lorenzalber/SnowLens/hardware/SnowLens_Schematic_and_Board.pdf

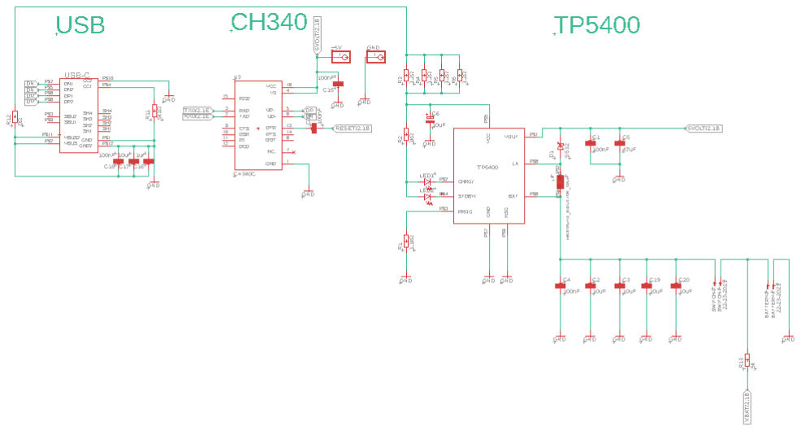
[picture p79: figure]

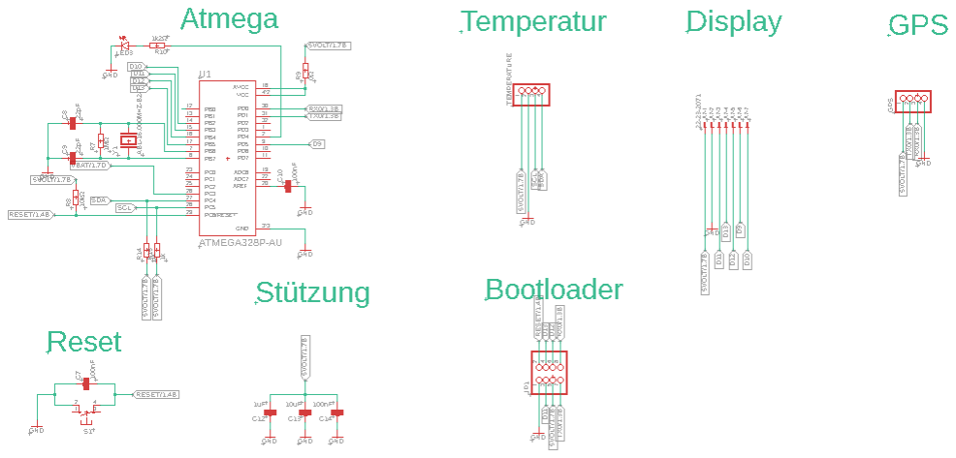
[picture p80: figure]

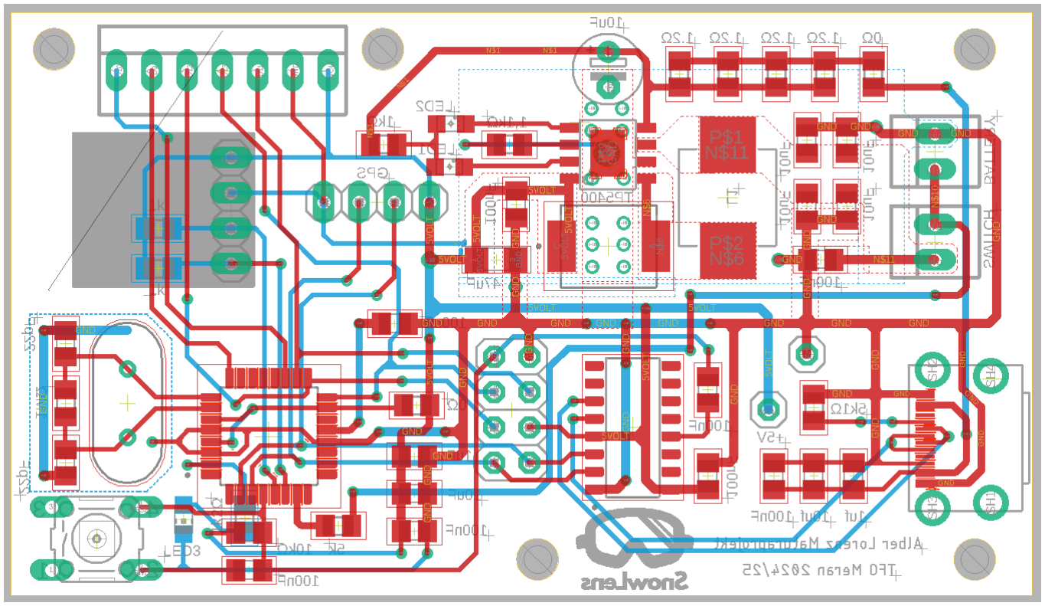
[picture p81: figure]
